Ccmra404/zigbee-vw-sensor/outputs/ch8_logic_diagram.png

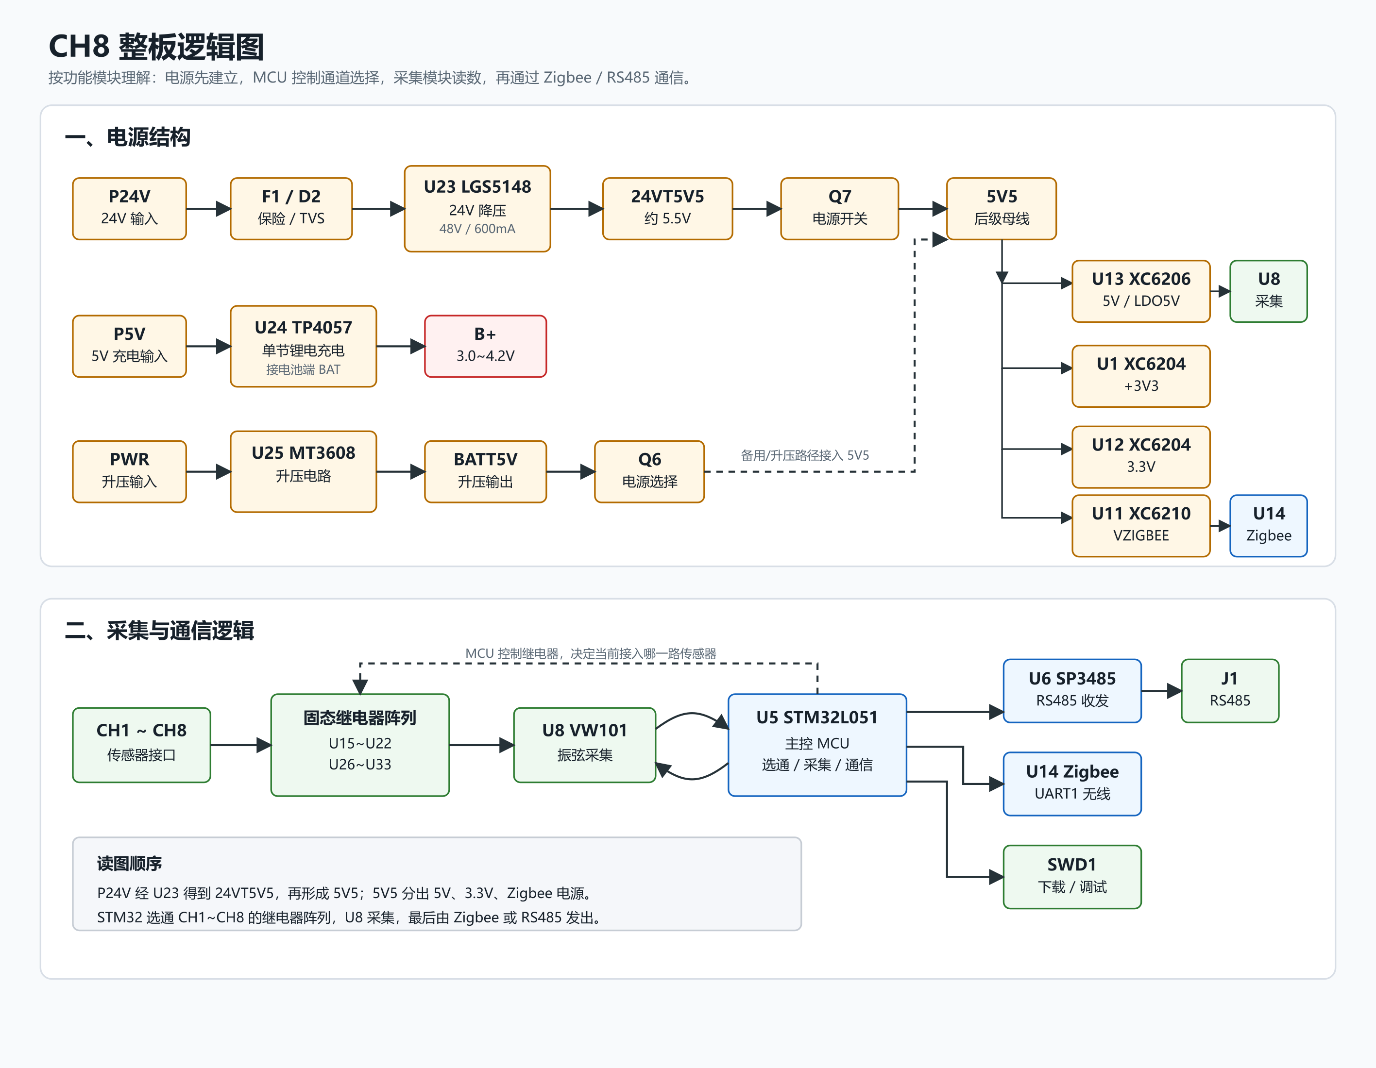
outputs/ch8_logic_diagram.png
