Ccmra404/zigbee-vw-sensor/INC_unzip/INC/HY65ASCII_CLIENT.h

/*
例如：
发送串
'H' 'Y' '6' '5' 01h 'R' '0' checksum
表示取得工号=1的传感器的读数，这里的checksum='H'+'Y'+'6'+'5'+01h+'R'+'0'。

返回串
'H' 'Y' '6' '5' 01h 'R' 'O' '+' '0' '0' '0' '0' '0' '0' '0' '9' '0' checksum
表示工号为1的传感器当前读数有效且=+9,这里的

checksum='H'+'Y'+'6'+'5'+01h+'R'+'O'+'+'+'0'+'0'+'0'+'0'+'0'+'0'+'0'+'9'+'0'。

发送串
'H' 'Y' '6' '5' 01h 'Z' '0' checksum
表示给工号=1的传感器的当前读数清零，这里的checksum='H'+'Y'+'6'+'5'+01h+'Z'+'0'。

返回串
'H' 'Y' '6' '5' 01h 'Z' 'O' '+' '0' '0' '0' '0' '0' '0' '0' '0' '0' checksum
表示工号为1的传感器清零成功，

checksum='H'+'Y'+'6'+'5'+01h+'R'+'O'+'+'+'0'+'0'+'0'+'0'+'0'+'0'+'0'+'0'+'0'。
*/

#include "HYDZHEAD.h"

#ifndef __HY65ASCII_CLIENT__
#define __HY65ASCII_CLIENT__		1
#ifdef _MSC_VER
#if _MSC_VER > 1000
#pragma pack(push)
#pragma pack(2)				//2 bytes边界对齐the same as 430 does
#endif
#endif

#define HY65ASCII_S_HEADFLAG 0x58543536    //"65TX"
#define HY65ASCII_R_HEADFLAG 0x58523536    //"65RX"

typedef struct HY65ASCII_S_STRUCT         //ASCII方式发送命令结构
{
  unsigned long hy65ascii_s_headflag;       //头标志,总是=HY65ASCII_S_HEADFLAG
  unsigned char group_number[3];             //传感器工号
  unsigned char ascii_command;            //ASCII模式的命令
  unsigned char reserved;                 //保留,暂时未用,建议置为字符'0'
  unsigned char checksum;                 //校验和,结构中其它部分的字节累加和
}HY65ASCII_S,*LPHY65ASCII_S;
#define HY65ASCII_S_SIZE sizeof(HY65ASCII_S)

#define HY65ASCII_S_COMMAND_C_HY65_STATUS  'S'      //取得传感器读数命令
#define HY65ASCII_S_COMMAND_C_HY65_SETZERO 'Z'      //传感器当前读数置零命令
#define HY65ASCII_S_COMMAND_C_HY65_LASTERROR 'L'    //取得传感器上个命令的执行情况，检查返回的HY65ASCII_R结构中的error_flag,如果='O'表示命令正确完成
  
typedef struct HY65ASCII_R_STRUCT       //ASCII方式传感器返回结构
{
  unsigned long hy65ascii_r_headflag;       //头标志,总是=HY65ASCII_R_HEADFLAG
  unsigned char group_number[3];             //传感器工号
  unsigned char ascii_command;            //ASCII模式的命令
  unsigned char error_flag;               //传感器响应的命令完成标志，='O'时标示传感器正确完成命令(或者传感器读数正确)，不等于'O'时表示传感器执行命令失败或者传感器读数无效
  unsigned char sign_flag;                //传感器读数符号,'+'表示正数，'-'表示负数
  unsigned char ascii_result[6];          //从高位到低位的ASCII码组成的传感器读数，例如"000036"表示传感器读数=36
  unsigned char reserved;                 //保留,暂时未用
  unsigned char checksum;                 //校验和,结构中其它部分的字节累加和
}HY65ASCII_R,*LPHY65ASCII_R;
#define HY65ASCII_R_SIZE sizeof(HY65ASCII_R)

#define HY65ASCII_R_ERROR_OK   'O'         //error_flag OK标志

void ASCII_ControlCommand(void);
BOOL ASCII_CommandCheck(LPHY65ASCII_S pASCII);


#ifdef _MSC_VER
#if _MSC_VER > 1000
#pragma pack(pop)				//恢复old边界对齐
#endif
#endif
#endif
