Ccmra404/zigbee-vw-sensor/(commit log)

2026-07-02 Initial commit: 振弦传感器 Zigbee 无线节点项目
    - EasyEDA PCB 设计 (Zigbee版)
    - STM32L0 固件 (四通道振弦采集, HY65协议, 433MHz遥控)
    - Python 分析工具链 (PCB解析, 历史数据解密)
    - INC 头文件 (HY65/HYDZ 协议)
2026-07-02 Add STM32L051_8CH firmware - current version with app_controller refactoring
    - 8-channel vibrating wire sensor node firmware
    - Modular architecture: app_controller, ch8_measure, zdyh_cmd, hy65_ascii_cmd
    - HY65/ZDYH 40-byte binary protocol + 65TX/65RX ASCII protocol
    - Modbus RTU VM101 sensor interface with GPIO-mux channel selection
    - Zigbee DRF1609 + 433MHz E330 remote wake-up
    - Ultra-low-power STOP mode with LPUART wake
    - Flash-based EEPROM emulation for configuration persistence
    - Build: Keil MDK-ARM V5 (ARMCC V5.06)
    - MCU: STM32L051C8Tx (Cortex-M0+, 64KB Flash, 8KB RAM)
    [STM32L051_8CH.ioc, app_config.c, app_config.h, app_controller.c, app_delay.c, app_delay.h, ch8_measure.c]
2026-07-02 Add v2.0 changelog — 4ch to 8ch major refactoring
2026-07-02 Refactor firmware UART state handling
    Add app_uart for shared UART runtime state, narrow app_controller exports, remove unused ADC/IWDG modules, and simplify Zigbee ACK handling.
2026-07-03 Hardware-firmware synchronization: swap UART1/2, remove E330/LPUART1, remove power control
    - Swap USART1 (now Zigbee+RS485) and USART2 (now VM101)
    - Remove all E330 433MHz remote module / LPUART1 code
    - Remove power control GPIOs (power always on per hardware)
    - GPIO: PB0-PB7 = channel relay select, PB8-PB15 = analog/NC
    - Clean up unused functions and declarations
    - Build: 0 Error 0 Warning, STM32L051C8T6
    [STM32L051_8CH.ioc, app_controller.c, app_uart.c, app_uart.h, ch8_measure.c, gpio.c, hy65_protocol.c]
